GraphTechKEN/SELDController/ME38_MC53_BVE_VM_V4.2.0.6.pdf

# Arduino Micro

## 速度計

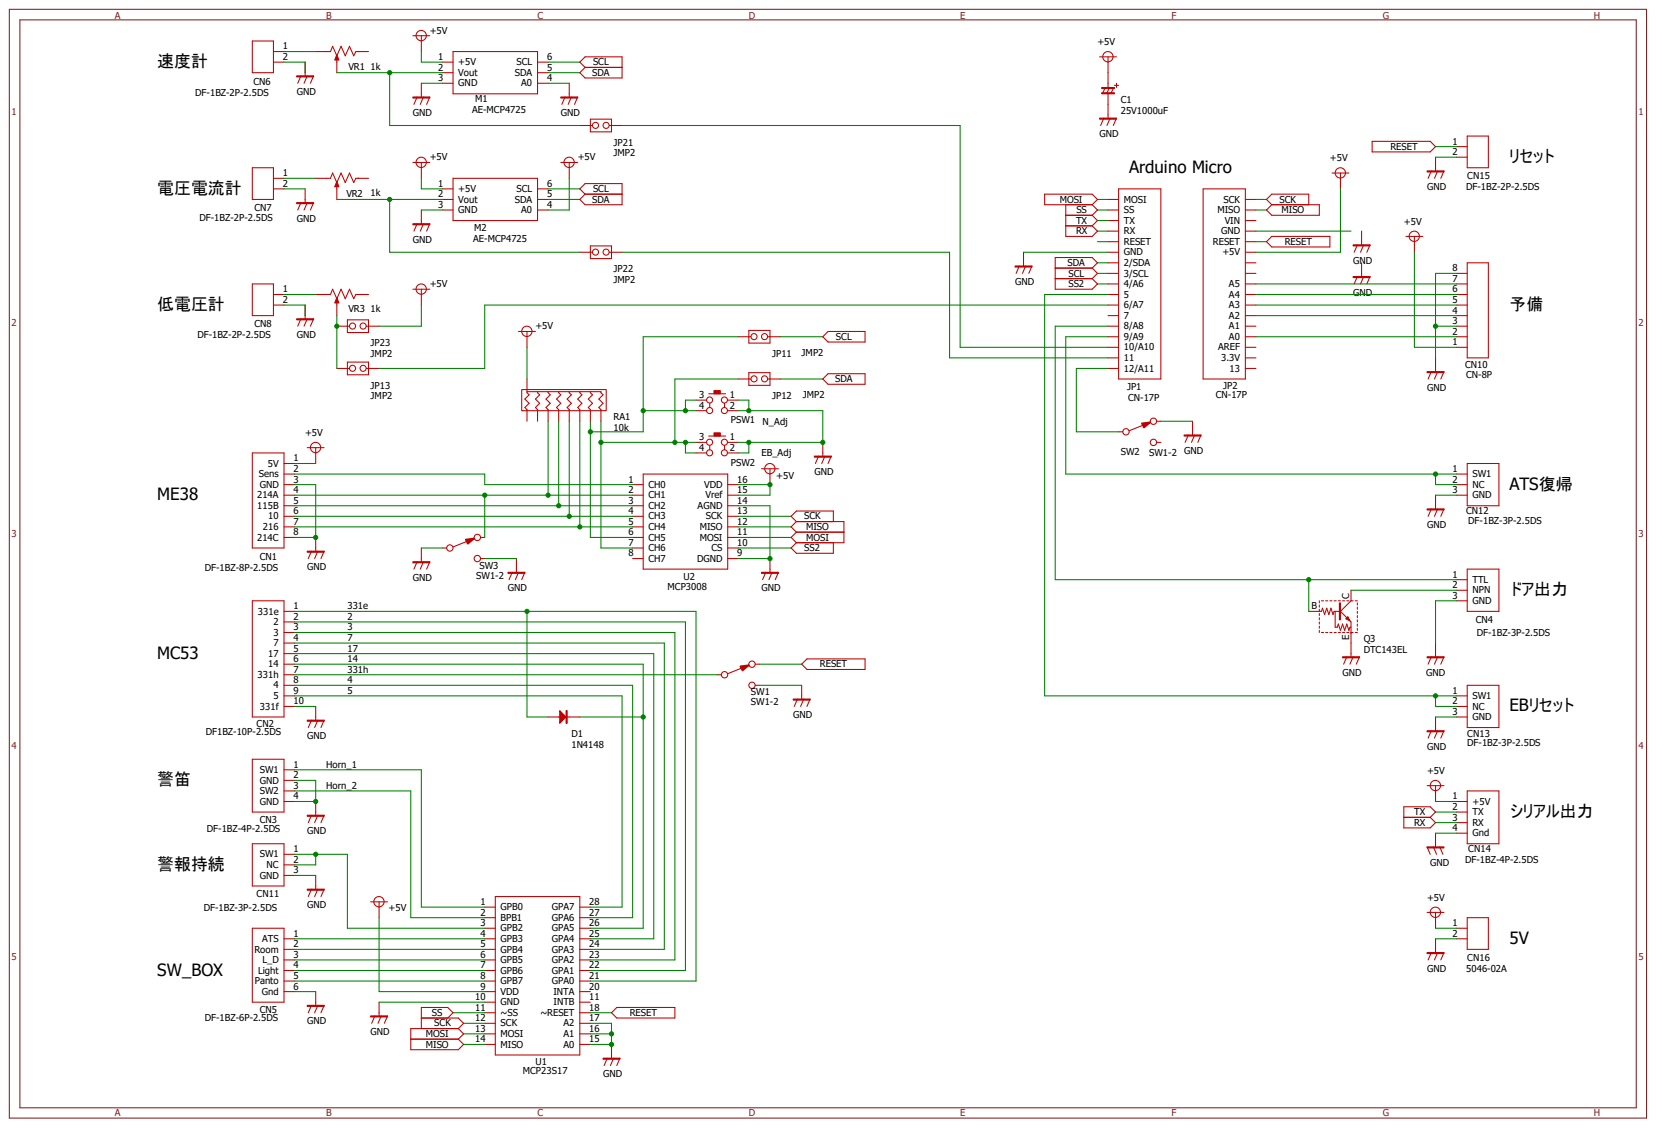
[picture p1: page 1]

+5V 1 Vout 2 SDA A0 | SCL 5
GND 3 | SDA 4

GND | 6

1 | SDA JP12 JMP2

CH4 5 | MISO

2 2
3 3
4 7

SS | MISO 14 MOSI 13 | RESET
