GraphTechKEN/SELDController/(commit log)

2025-03-15 V4.1.2.4
    JRETS185に仮対応
2025-04-04 V4.1.2.5
    V4.2.1.5 マスコンEBに対応
2025-05-14 V4.2.1.6
    外部からのキー入力に対応("KEY c"c:char or "KEY 0xXX")
2025-05-25 V4.2.1.7
    軽量化および文字列のポインタ→参照渡しへ修正、ブレーキ弁調整モードを削除、エアー不使用時にATS直下など非常ブレーキ動作を導入
2025-05-26 V4.1.2.8
    BveEX起動時、直通帯でEB解除とならなかったため修正
2025-05-30 V4.2.1.9
    抑速段に入った場合でも1ノッチを投入する(PIN_MC1の判定をorで追加)
2025-06-10 V4.1.2.9
    抑速段に入った場合でも1ノッチを投入する(PIN_DECの判定のみ)
2025-06-10 V4.2.2.1
    ブレーキ弁EB入力対応
2025-06-10 V4.2.2.1
    ブレーキ弁EB入力対応、ATSMxコマンドの修正
2025-06-19 V4.2.2.2
    事故モードを追加、マスコン、レバーサ無効、抑速段処理軽量化、Serial1→USB通信修正
2025-07-07 README.md の更新
2025-07-10 V4.2.2.3
    模型モード(modeN)トグルスイッチ修正、キーボード処理、マスコン処理周辺軽量化
2025-07-18 V4.2.2.4
    模型モード修正、キーボード処理、マスコン処理周辺軽量化
2025-07-19 V4.2.2.5
    USB入力とSerial入力判定部を共通化
2025-07-21 V4.2.2.5
    USB入力とSerial入力判定部を共通化、微修正
2025-09-14 V4.2.2.6
    設定データのReturnが認知できなかったエラーを修正
2025-09-19 V4.2.2.7
    不具合修正、Pan降下シーケンス(表示灯リセット)追加
2025-10-03 V4.2.2.8
    非常の'/'連打をやめる
2025-11-22 Update README with links for circuit board options
    Added links for both assembled and unassembled circuit boards.
2026-03-10 v4.2.3.1
    //V4.2.2.9 模型モード微修正(トグル操作orコマンド操作でB8、Pノッチリセット)
    //V4.2.3.0 交直切替対応
    //V4.2.3.1 容量削減のためライブラリの使用を停止
    [SELDController.ino]
2026-03-15 V4.2.3.2
    ノッチ自動合わせの選択肢にシナリオ開始時のみを追加、前照灯(PageUp)、減光(PageDown)試験実装、パンタ下ボタンに'Alt+F4’or'P'を選択式とした
2026-03-16 V4.2.3.2-2
    1168行 Ats_Conf_Flip >> 2 を >>1に変更
2026-03-28 v4.3.2.3
    B1接点情報伝送追加 076 1:ポテンショ 0:接点
2026-04-01 V4.2.3.4
    ATS電源接点情報伝送追加 076 5bit 1:ポテンショ 0:接点 084:ATS電源角度(ME48)
2026-04-02 SELDController.ino の更新
    uint16_t read_Break()をvoidに変更
2026-04-04 V4.2.3.5
    B1接点情報のチャタリング防止追加
2026-04-04 V4.2.3.5-2
    B1接点情報のチャタリング防止追加、ATS復帰スイッチが動作しないバグ修正
2026-05-02 Fix link formatting in README.md
    Updated README to correct link formatting for pressure control.
2026-05-03 V4.2.3.6
    自動帯から直通帯に戻した際ブレーキがかからなくなる重大インシデントを修正、USBシリアル通信非接続時の動作安定化
2026-06-02 V4.2.3.9-2
    バージョン管理を追加
2026-06-02 V4.2.3.10
    後段に非常状態を転送する機能を選択可とする 076 6bit:非常投入状態転送(36) 0:無効 1:有効
2026-07-08 V4.2.3.11
    強制BVEモード追加、受信電文に対してLFの読み飛ばしを追加
